ShawnVictor/Project-Quasar-Software/Quasar_Eagle_Files/Quasar_DAQ_Board/Quasar_v0.1.brd

## EAGLE design Quasar_Eagle_Files/Quasar_DAQ_Board/Quasar_v0.1.brd (2020-03-15)

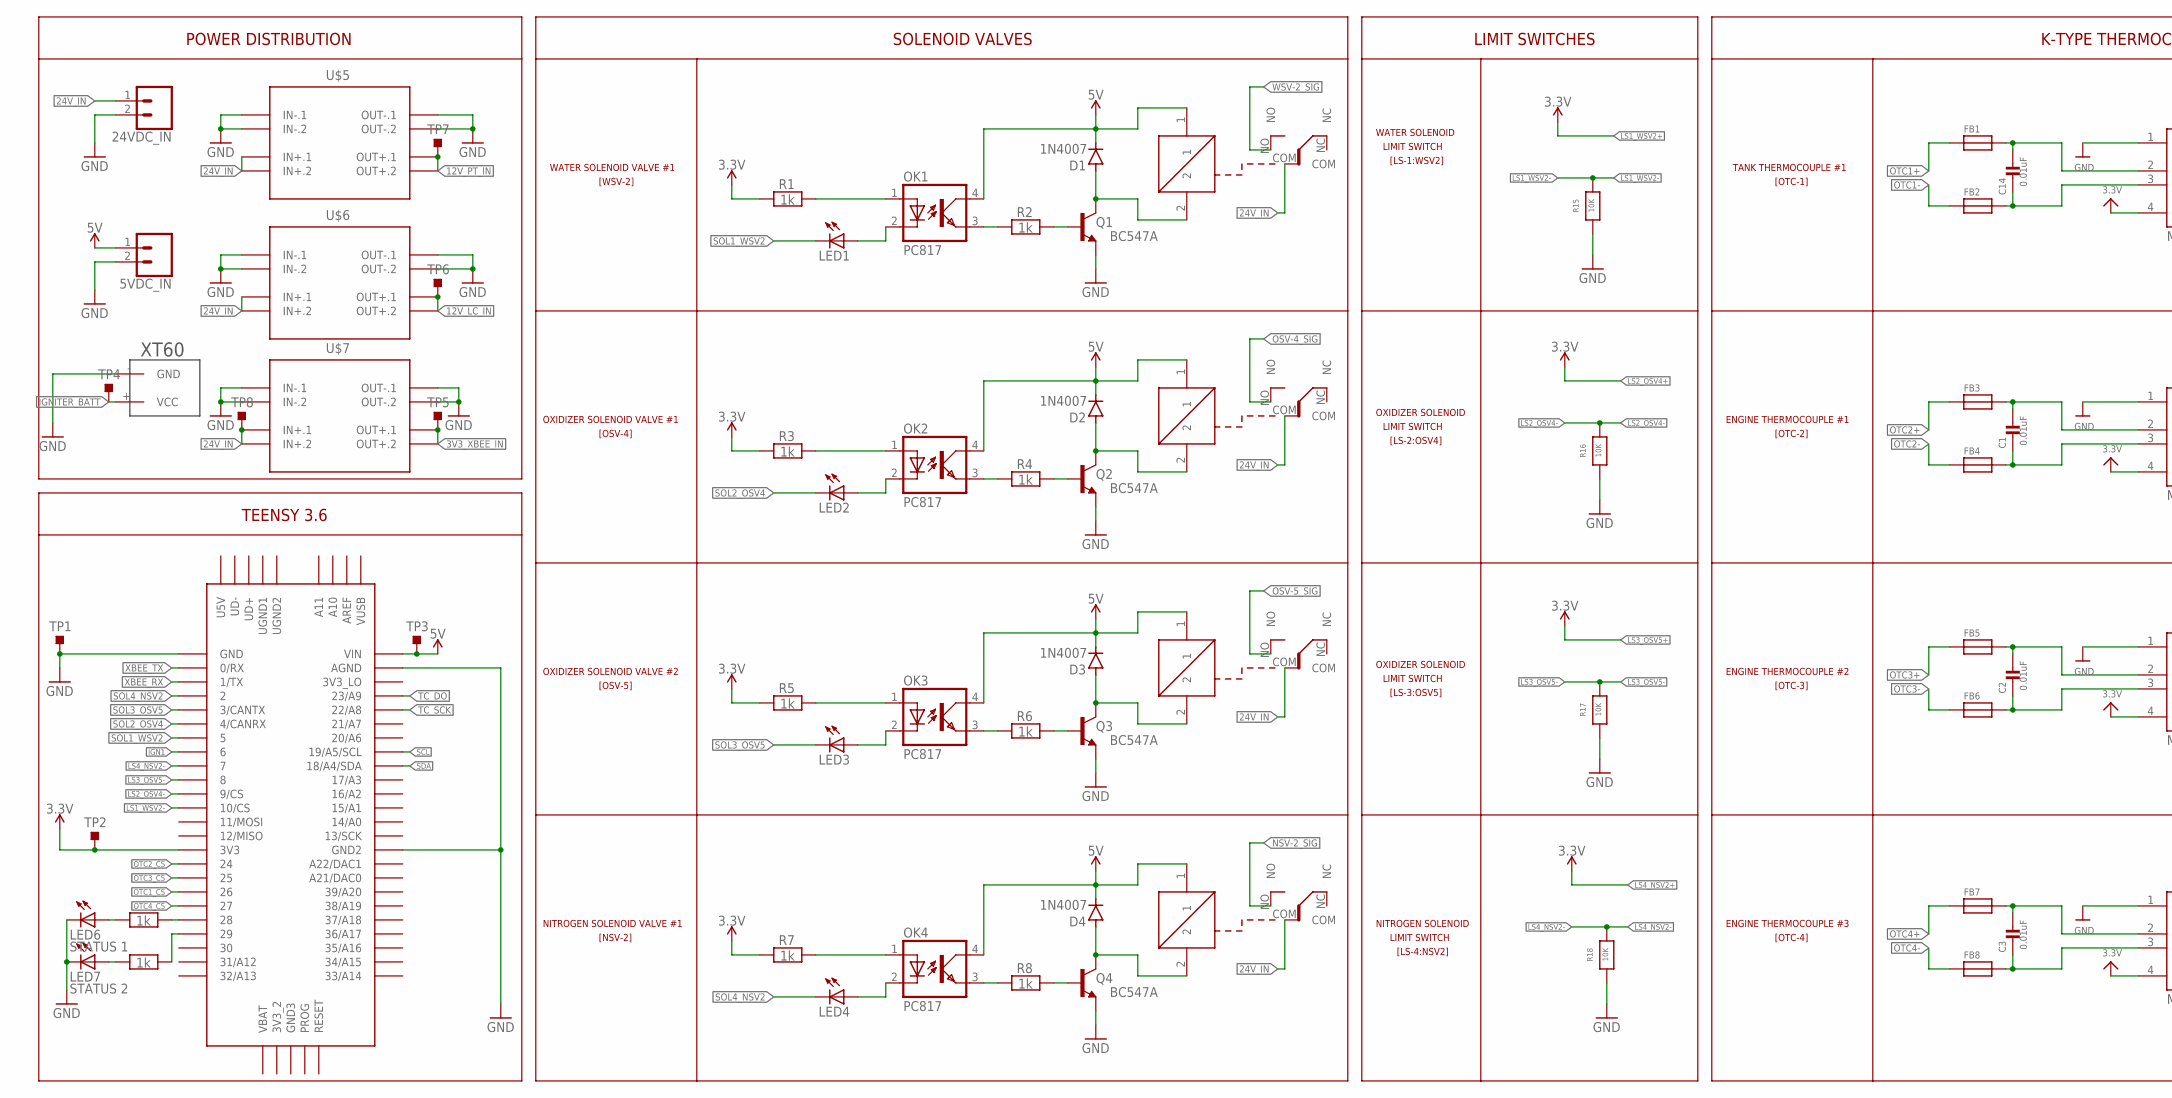
[picture p3: schematic Quasar_v0.1.sch, part in row 1, column 1]

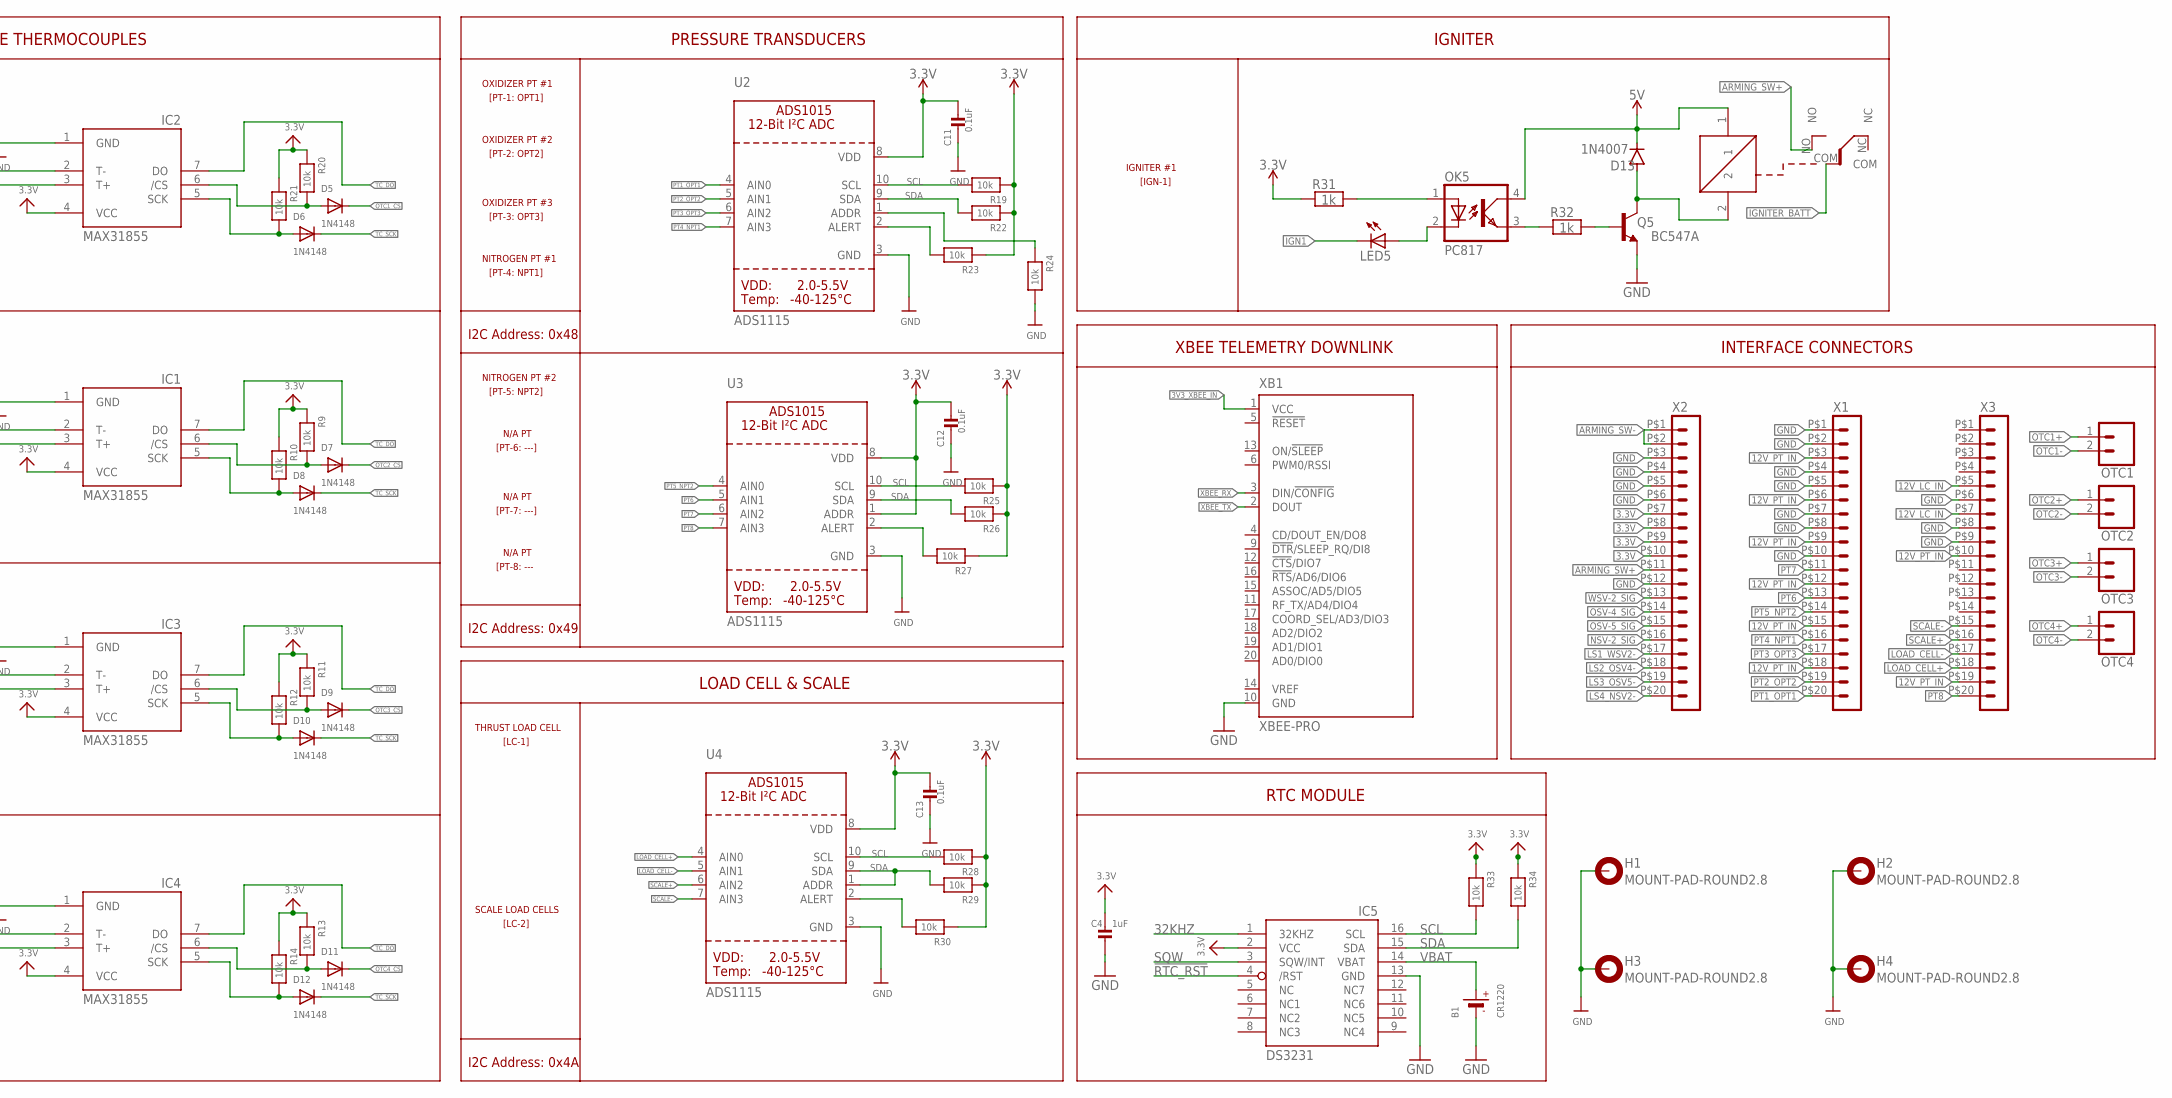
[picture p4: schematic Quasar_v0.1.sch, part in row 1, column 2]

Parts:
5VDC_IN, 24VDC_IN: CONN_025MM; SCREWTERMINAL-5MM-2
B1: CR1220
C1, C2, C3, C14: 0.01uF; 0805
C4: 1uF; 0805
C11, C12, C13: 0.1uF; 0805
D1, D2, D3, D4, D13: 1N4007; DO-41
D5, D6, D7, D8, D9, D10, D11, D12: 1N4148; SOD-123
FB1, FB2, FB3, FB4, FB5, FB6, FB7, FB8: FERRITE; 0603
H1, H2, H3, H4: MOUNT-PAD-ROUND2.8; 2,8-PAD
IC1, IC2, IC3, IC4: MAX31855; SO08
IC5: DS3231/SO; SO16W
LED1, LED2, LED3, LED4, LED5: LEDCHIPLED_1206; CHIPLED_1206
LED6: STATUS 1; LED5MM
LED7: STATUS 2; LED5MM
OK1, OK2, OK3, OK4, OK5: PC817; DIL04
OTC1, OTC2, OTC3, OTC4: CONN_025MM; SCREWTERMINAL-5MM-2
Q1, Q2, Q3, Q4, Q5: BC547A; TO92
R1, R2, R3, R4, R5, R6, R7, R8, R31, R32, R35, R36: 1k; 0805
R9, R10, R11, R12, R13, R14, R19, R20, R21, R22, R23, R24, R25, R26, R27, R28, R29, R30, R33, R34: 10k; 0805
R15, R16, R17, R18: 10K; 0805
TP1, TP2, TP3, TP4, TP5, TP6, TP7, TP8: TESTPOINT_TPS-SMD-10SN; TESTPOINT_SMD-10SN
U2, U3, U4: ADS1115; MSOP10
U$1: TEENSY_3.5/3.6
U$2, U$3, U$4, U$13, U$18: RW-SH
U$5: 12V_PT_REG; DC-DC-STEP-DOWN-MP1584
U$6: 12V_LC_REG; DC-DC-STEP-DOWN-MP1584
U$7: 3V3_XBEE_REG; DC-DC-STEP-DOWN-MP1584
U$19: XT60
X1, X2, X3: HEADER_POS20_44914-2001; 44914-2001
XB1: XBEE-PRO

Connections:
3.3V: C4.2, C11.2, C12.2, C13.2, IC1.4 (VCC), IC2.4 (VCC), IC3.4 (VCC), IC4.4 (VCC), IC5.2 (VCC), R1.2, R3.2, R5.2, R7.2, R9.1, R10.1, R11.1, R12.1, R13.1, R14.1, R19.1, R20.1, R21.1, R22.1, R23.1, R25.1, R26.1, R27.1, R28.1, R29.1, R30.1, R31.2, R33.1, R34.1, TP2.TP, U2.8 (VDD), U3.1 (ADDR), U3.8 (VDD), U4.8 (VDD), U$1.3V3, X2.P$7 (7), X2.P$8 (8), X2.P$9 (9), X2.P$10 (10)
3V3_XBEE_IN: TP5.TP, U$7.OUT+.1, U$7.OUT+.2, XB1.1 (VCC)
5V: 5VDC_IN.1, D1.C, D2.C, D3.C, D4.C, D13.C, OK1.4 (COL), OK2.4 (COL), OK3.4 (COL), OK4.4 (COL), OK5.4 (COL), TP3.TP, U$1.VIN, U$2.1, U$3.1, U$4.1, U$13.1, U$18.1
12V_LC_IN: TP6.TP, U$6.OUT+.1, U$6.OUT+.2, X3.P$5 (5), X3.P$7 (7)
12V_PT_IN: TP7.TP, U$5.OUT+.1, U$5.OUT+.2, X1.P$3 (3), X1.P$6 (6), X1.P$9 (9), X1.P$12 (12), X1.P$15 (15), X1.P$18 (18), X3.P$10 (10), X3.P$19 (19)
24V_IN: 24VDC_IN.1, TP8.TP, U$2.COM, U$3.COM, U$4.COM, U$5.IN+.1, U$5.IN+.2, U$6.IN+.1, U$6.IN+.2, U$7.IN+.1, U$7.IN+.2, U$13.COM
32KHZ: IC5.1 (32KHZ)
!RTC_RST: IC5.4 (/RST)
ARMING_SW+: U$18.NO, X2.P$11 (11)
ARMING_SW-: X2.P$1 (1), X2.P$2 (2)
GND: 5VDC_IN.2, 24VDC_IN.2, B1.-, C4.1, C11.1, C12.1, C13.1, H1.B2,8, H2.B2,8, H3.B2,8, H4.B2,8, IC1.1 (GND), IC2.1 (GND), IC3.1 (GND), IC4.1 (GND), IC5.13 (GND), LED6.K (C), LED7.K (C), Q1.1 (E), Q2.1 (E), Q3.1 (E), Q4.1 (E), Q5.1 (E), R15.2, R16.2, R17.2, R18.2, R24.2, TP1.TP, U2.3 (GND), U3.3 (GND), U4.3 (GND), U$1.AGND, U$1.GND, U$1.GND2, U$5.IN-.1, U$5.IN-.2, U$5.OUT-.1, U$5.OUT-.2, U$6.IN-.1, U$6.IN-.2, U$6.OUT-.1, U$6.OUT-.2, U$7.IN-.1, U$7.IN-.2, U$7.OUT-.1, U$7.OUT-.2, U$19.- (GND), X1.P$1 (1), X1.P$2 (2), X1.P$4 (4), X1.P$5 (5), X1.P$7 (7), X1.P$8 (8), X1.P$10 (10), X2.P$3 (3), X2.P$4 (4), X2.P$5 (5), X2.P$6 (6), X2.P$12 (12), X3.P$6 (6), X3.P$8 (8), X3.P$9 (9), XB1.10 (GND)
IGN1: LED5.C, U$1.6
IGNITER_BATT: TP4.TP, U$18.COM, U$19.+ (VCC)
LOAD_CELL+: U4.4 (AIN0), X3.P$18 (18)
LOAD_CELL-: U4.5 (AIN1), X3.P$17 (17)
LS1_WSV2-: R15.1, U$1.10/CS, X2.P$17 (17)
LS2_OSV4-: R16.1, U$1.9/CS, X2.P$18 (18)
LS3_OSV5-: R17.1, U$1.8, X2.P$19 (19)
LS4_NSV2-: R18.1, U$1.7, X2.P$20 (20)
unnamed: OK1.1 (A), R1.1
unnamed: LED1.A, OK1.2 (C)
unnamed: Q1.2 (B), R2.1
unnamed: OK1.3 (EMIT), R2.2
unnamed: D1.A, Q1.3 (C), U$13.2
unnamed: OK2.1 (A), R3.1
unnamed: LED2.A, OK2.2 (C)
unnamed: Q2.2 (B), R4.1
unnamed: OK2.3 (EMIT), R4.2
unnamed: D2.A, Q2.3 (C), U$2.2
unnamed: OK3.1 (A), R5.1
unnamed: LED3.A, OK3.2 (C)
unnamed: Q3.2 (B), R6.1
unnamed: OK3.3 (EMIT), R6.2
unnamed: D3.A, Q3.3 (C), U$3.2
unnamed: OK4.1 (A), R7.1
unnamed: LED4.A, OK4.2 (C)
unnamed: Q4.2 (B), R8.1
unnamed: OK4.3 (EMIT), R8.2
unnamed: D4.A, Q4.3 (C), U$4.2
unnamed: C1.2, FB3.2, IC1.2 (T-)
unnamed: C1.1, FB4.2, IC1.3 (T+)
unnamed: D7.A, IC1.6 (/CS), R9.2
unnamed: D8.A, IC1.5 (SCK), R10.2
unnamed: C2.2, FB5.2, IC3.2 (T-)
unnamed: C2.1, FB6.2, IC3.3 (T+)
unnamed: C14.1, FB2.2, IC2.3 (T+)
unnamed: D9.A, IC3.6 (/CS), R11.2
unnamed: D10.A, IC3.5 (SCK), R12.2
unnamed: C3.2, FB7.2, IC4.2 (T-)
unnamed: C3.1, FB8.2, IC4.3 (T+)
unnamed: C14.2, FB1.2, IC2.2 (T-)
unnamed: D11.A, IC4.6 (/CS), R13.2
unnamed: D5.A, IC2.6 (/CS), R20.2
unnamed: D12.A, IC4.5 (SCK), R14.2
unnamed: OK5.1 (A), R31.1
unnamed: LED5.A, OK5.2 (C)
unnamed: Q5.2 (B), R32.1
unnamed: R23.2, U2.2 (ALERT)
unnamed: R27.2, U3.2 (ALERT)
unnamed: R24.1, U2.1 (ADDR)
unnamed: OK5.3 (EMIT), R32.2
unnamed: D13.A, Q5.3 (C), U$18.2
unnamed: R30.2, U4.2 (ALERT)
unnamed: R35.1, U$1.28
unnamed: R36.1, U$1.29
unnamed: D6.A, IC2.5 (SCK), R21.2
unnamed: LED6.A, R35.2
unnamed: LED7.A, R36.2
NSV-2_SIG: U$4.NO, X2.P$16 (16)
OSV-4_SIG: U$2.NO, X2.P$14 (14)
OSV-5_SIG: U$3.NO, X2.P$15 (15)
OTC1+: FB1.1, OTC1.1
OTC1-: FB2.1, OTC1.2
OTC1_CS: D5.C, U$1.26
OTC2+: FB3.1, OTC2.1
OTC2-: FB4.1, OTC2.2
OTC2_CS: D7.C, U$1.24
OTC3+: FB5.1, OTC3.1
OTC3-: FB6.1, OTC3.2
OTC3_CS: D9.C, U$1.25
OTC4+: FB7.1, OTC4.1
OTC4-: FB8.1, OTC4.2
OTC4_CS: D11.C, U$1.27
PT1_OPT1: U2.4 (AIN0), X1.P$20 (20)
PT2_OPT2: U2.5 (AIN1), X1.P$19 (19)
PT3_OPT3: U2.6 (AIN2), X1.P$17 (17)
PT4_NPT1: U2.7 (AIN3), X1.P$16 (16)
PT5_NPT2: U3.4 (AIN0), X1.P$14 (14)
PT6: U3.5 (AIN1), X1.P$13 (13)
PT7: U3.6 (AIN2), X1.P$11 (11)
PT8: U3.7 (AIN3), X3.P$20 (20)
SCALE+: U4.6 (AIN2), X3.P$16 (16)
SCALE-: U4.7 (AIN3), X3.P$15 (15)
SCL: IC5.16 (SCL), R19.2, R25.2, R28.2, R33.2, U2.10 (SCL), U3.10 (SCL), U4.10 (SCL), U$1.19/A5/SCL
SDA: IC5.15 (SDA), R22.2, R26.2, R29.2, R34.2, U2.9 (SDA), U3.9 (SDA), U4.1 (ADDR), U4.9 (SDA), U$1.18/A4/SDA
SOL1_WSV2: LED1.C, U$1.5
SOL2_OSV4: LED2.C, U$1.4/CANRX
SOL3_OSV5: LED3.C, U$1.3/CANTX
SOL4_NSV2: LED4.C, U$1.2
SQW: IC5.3 (SQW/INT)
TC_DO: IC1.7 (DO), IC2.7 (DO), IC3.7 (DO), IC4.7 (DO), U$1.23/A9
TC_SCK: D6.C, D8.C, D10.C, D12.C, U$1.22/A8
VBAT: B1.+$1 (+), IC5.14 (VBAT)
WSV-2_SIG: U$13.NO, X2.P$13 (13)
XBEE_RX: U$1.1/TX, XB1.3 (DIN/!CONFIG)
XBEE_TX: U$1.0/RX, XB1.2 (DOUT)

Notes on the sheet:
POWER DISTRIBUTION
SOLENOID VALVES
WATER SOLENOID VALVE #1
[WSV-2]
OXIDIZER SOLENOID VALVE #1
[OSV-4]
OXIDIZER SOLENOID VALVE #2
[OSV-5]
NITROGEN SOLENOID VALVE #1
[NSV-2]
TEENSY 3.6
K-TYPE THERMOCOUPLES
TANK THERMOCOUPLE #1
[OTC-1]
ENGINE THERMOCOUPLE #1
[OTC-2]
ENGINE THERMOCOUPLE #2
[OTC-3]
ENGINE THERMOCOUPLE #3
[OTC-4]
LIMIT SWITCHES
WATER SOLENOID
[LS-1:WSV2]
LIMIT SWITCH
OXIDIZER SOLENOID
[LS-2:OSV4]
[LS-3:OSV5]
NITROGEN SOLENOID
[LS-4:NSV2]
PRESSURE TRANSDUCERS
OXIDIZER PT #1
[PT-1: OPT1]
I2C Address: 0x48
OXIDIZER PT #2
[PT-2: OPT2]
OXIDIZER PT #3
[PT-3: OPT3]
NITROGEN PT #1
[PT-4: NPT1]
NITROGEN PT #2
[PT-5: NPT2]
N/A PT
[PT-6: ---]
[PT-7: ---]
[PT-8: ---
I2C Address: 0x49
LOAD CELL & SCALE
THRUST LOAD CELL
[LC-1]
SCALE LOAD CELLS
[LC-2]
I2C Address: 0x4A
IGNITER
IGNITER #1
[IGN-1]
XBEE TELEMETRY DOWNLINK
RTC MODULE
INTERFACE CONNECTORS

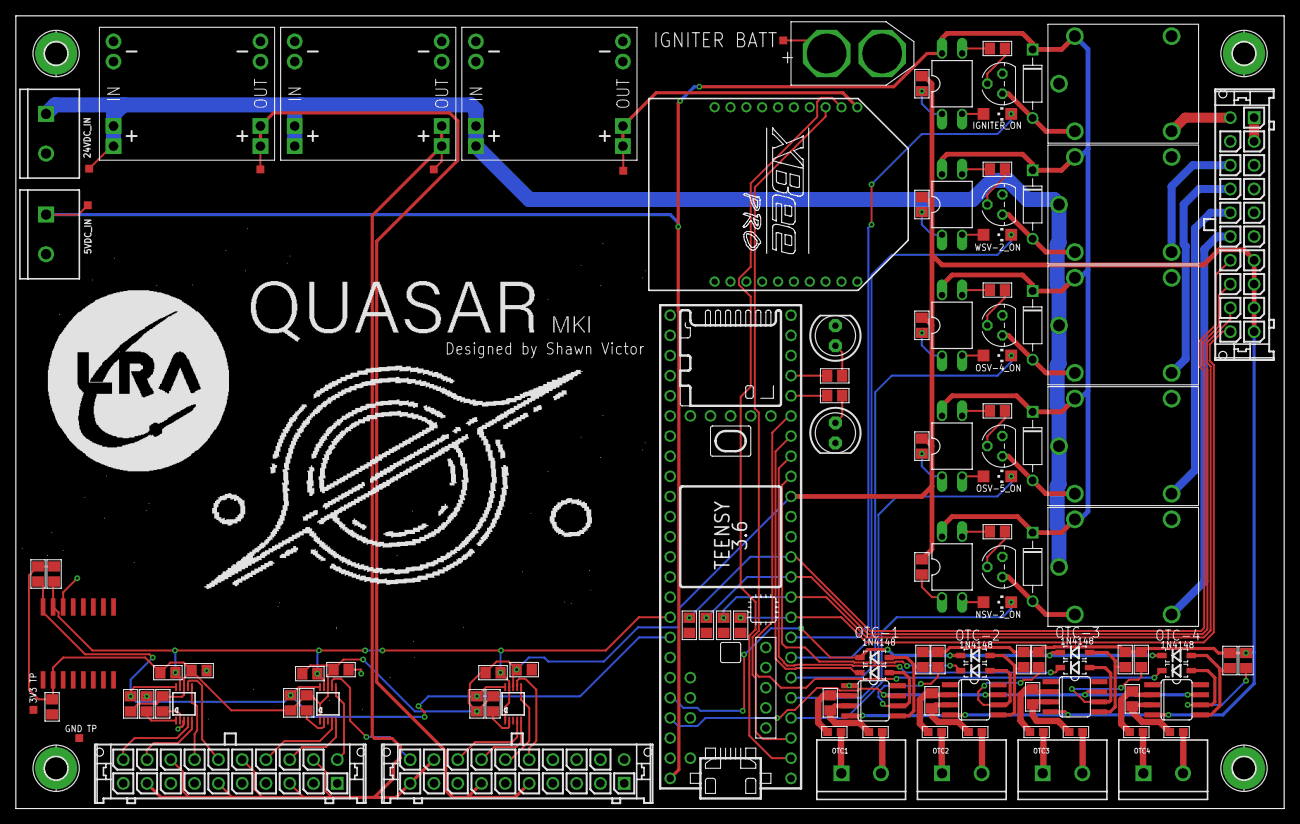
[picture p5: board Quasar_v0.1.brd from above]

Board: 2 copper layers, 160.0 x 100.0 mm, 123 parts (1 on the bottom side), 103 nets.
