ShawnVictor/Project-Quasar-Software/Quasar_Eagle_Files/Quasar_Control_Board/Quasar_Control_Board_v0.1.brd

## EAGLE design Quasar_Eagle_Files/Quasar_Control_Board/Quasar_Control_Board_v0.1.brd (2020-03-15)

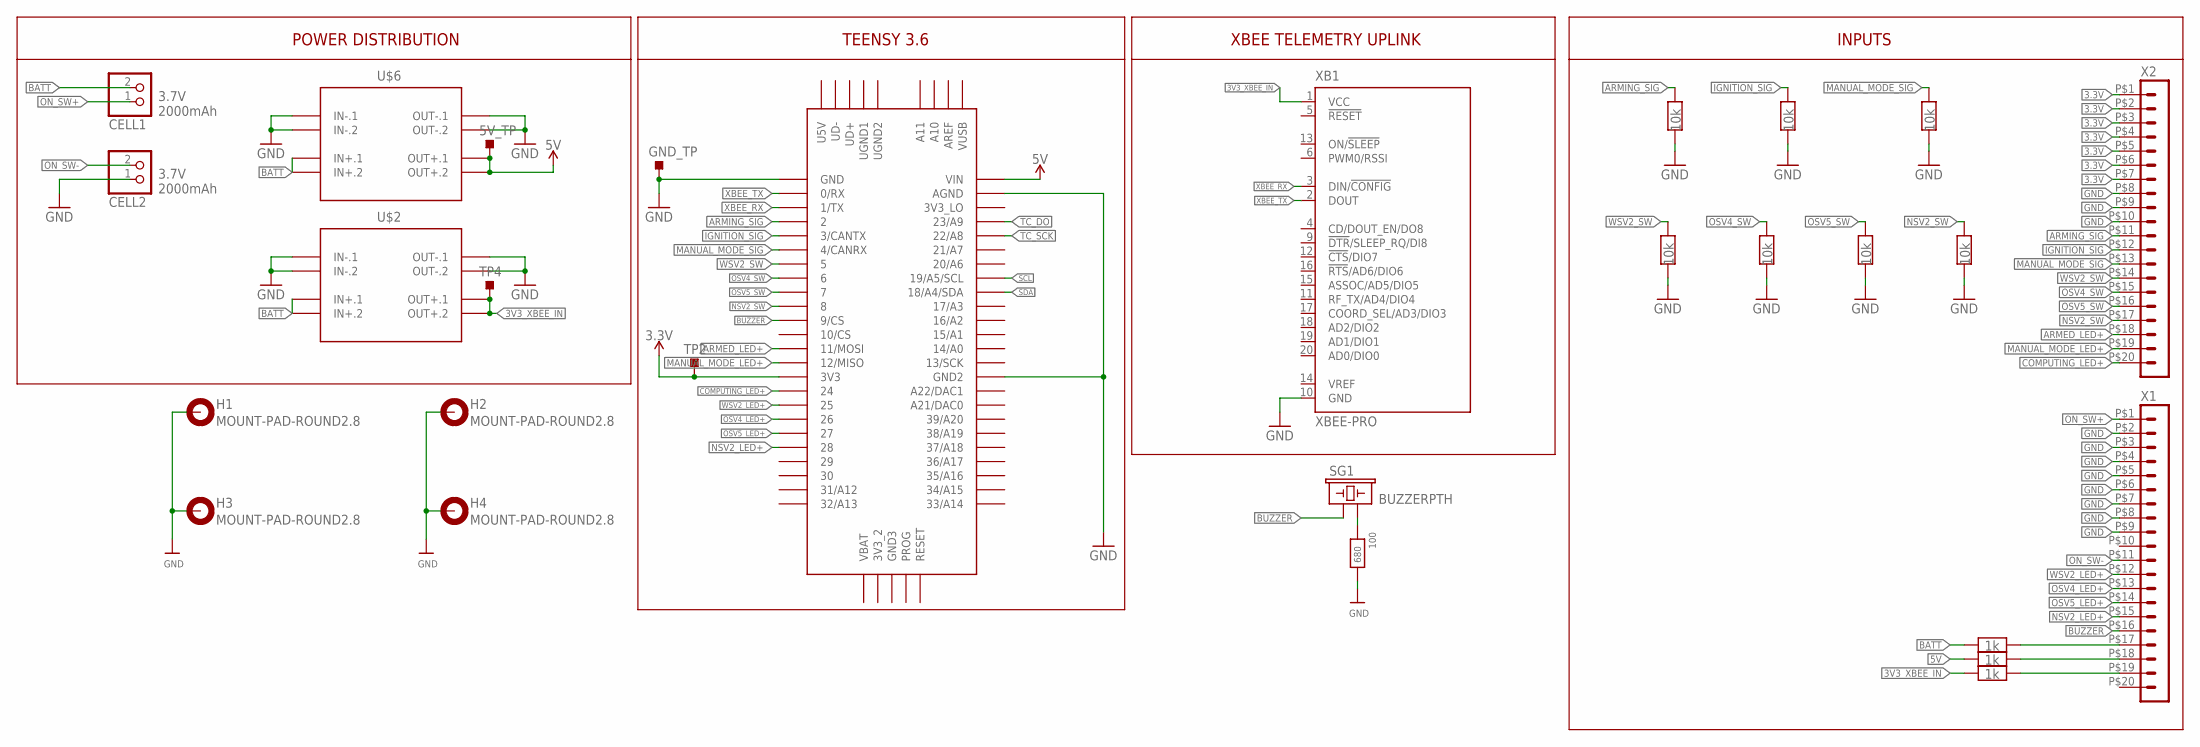
[picture p6: schematic Quasar_Control_Board_v0.1.sch]

Parts:
5V_TP: TESTPOINT_TPS-SMD-10SN; TESTPOINT_SMD-10SN
100: 680; 0603
CELL1, CELL2: JSTPH; JSTPH2
GND_TP: TESTPOINT_TPS-SMD-10SN; TESTPOINT_SMD-10SN
H1, H2, H3, H4: MOUNT-PAD-ROUND2.8; 2,8-PAD
R1, R2, R3, R4, R5, R6, R7: 10k; 0805
R8, R9, R10: 1k; 0805
SG1: BUZZERPTH; BUZZER-12MM
TP2, TP4: TESTPOINT_TPS-SMD-10SN; TESTPOINT_SMD-10SN
U$1: TEENSY_3.5/3.6
U$2, U$6: 12V_LC_REG; DC-DC-STEP-DOWN-MP1584
X1, X2: HEADER_POS20_44914-2001; 44914-2001
XB1: XBEE-PRO

Connections:
3.3V: TP2.TP, U$1.3V3, X2.P$1 (1), X2.P$2 (2), X2.P$3 (3), X2.P$4 (4), X2.P$5 (5), X2.P$6 (6), X2.P$7 (7)
3V3_XBEE_IN: R10.2, TP4.TP, U$2.OUT+.1, U$2.OUT+.2, XB1.1 (VCC)
5V: 5V_TP.TP, R9.2, U$1.VIN, U$6.OUT+.1, U$6.OUT+.2
ARMED_LED+: U$1.11/MOSI, X2.P$18 (18)
ARMING_SIG: R1.1, U$1.2, X2.P$11 (11)
BATT: CELL1.2, R8.2, U$2.IN+.1, U$2.IN+.2, U$6.IN+.1, U$6.IN+.2
BUZZER: SG1.+ (1), U$1.9/CS, X1.P$16 (16)
COMPUTING_LED+: U$1.24, X2.P$20 (20)
GND: 100.2, CELL2.1, GND_TP.TP, H1.B2,8, H2.B2,8, H3.B2,8, H4.B2,8, R1.2, R2.2, R3.2, R4.2, R5.2, R6.2, R7.2, U$1.AGND, U$1.GND, U$1.GND2, U$2.IN-.1, U$2.IN-.2, U$2.OUT-.1, U$2.OUT-.2, U$6.IN-.1, U$6.IN-.2, U$6.OUT-.1, U$6.OUT-.2, X1.P$2 (2), X1.P$3 (3), X1.P$4 (4), X1.P$5 (5), X1.P$6 (6), X1.P$7 (7), X1.P$8 (8), X1.P$9 (9), X2.P$8 (8), X2.P$9 (9), X2.P$10 (10), XB1.10 (GND)
IGNITION_SIG: R2.1, U$1.3/CANTX, X2.P$12 (12)
MANUAL_MODE_LED+: U$1.12/MISO, X2.P$19 (19)
MANUAL_MODE_SIG: R3.1, U$1.4/CANRX, X2.P$13 (13)
unnamed: R8.1, X1.P$17 (17)
unnamed: R9.1, X1.P$18 (18)
unnamed: R10.1, X1.P$19 (19)
unnamed: 100.1, SG1.- (2)
NSV2_LED+: U$1.28, X1.P$15 (15)
NSV2_SW: R7.1, U$1.8, X2.P$17 (17)
ON_SW+: CELL1.1, X1.P$1 (1)
ON_SW-: CELL2.2, X1.P$11 (11)
OSV4_LED+: U$1.26, X1.P$13 (13)
OSV4_SW: R5.1, U$1.6, X2.P$15 (15)
OSV5_LED+: U$1.27, X1.P$14 (14)
OSV5_SW: R6.1, U$1.7, X2.P$16 (16)
SCL: U$1.19/A5/SCL
SDA: U$1.18/A4/SDA
TC_DO: U$1.23/A9
TC_SCK: U$1.22/A8
WSV2_LED+: U$1.25, X1.P$12 (12)
WSV2_SW: R4.1, U$1.5, X2.P$14 (14)
XBEE_RX: U$1.1/TX, XB1.3 (DIN/!CONFIG)
XBEE_TX: U$1.0/RX, XB1.2 (DOUT)

Notes on the sheet:
TEENSY 3.6
XBEE TELEMETRY UPLINK
POWER DISTRIBUTION
3.7V 2000mAh
INPUTS

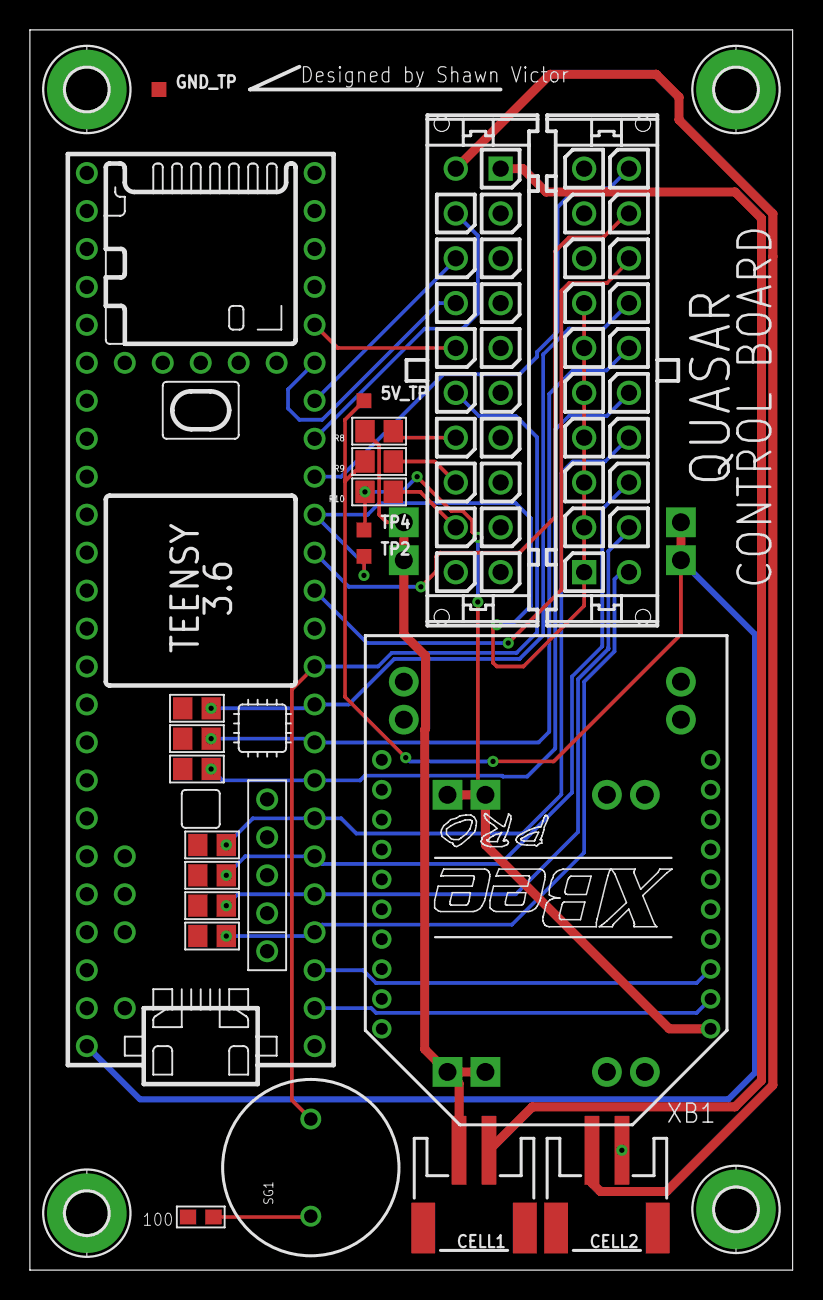
[picture p7: board Quasar_Control_Board_v0.1.brd from above]

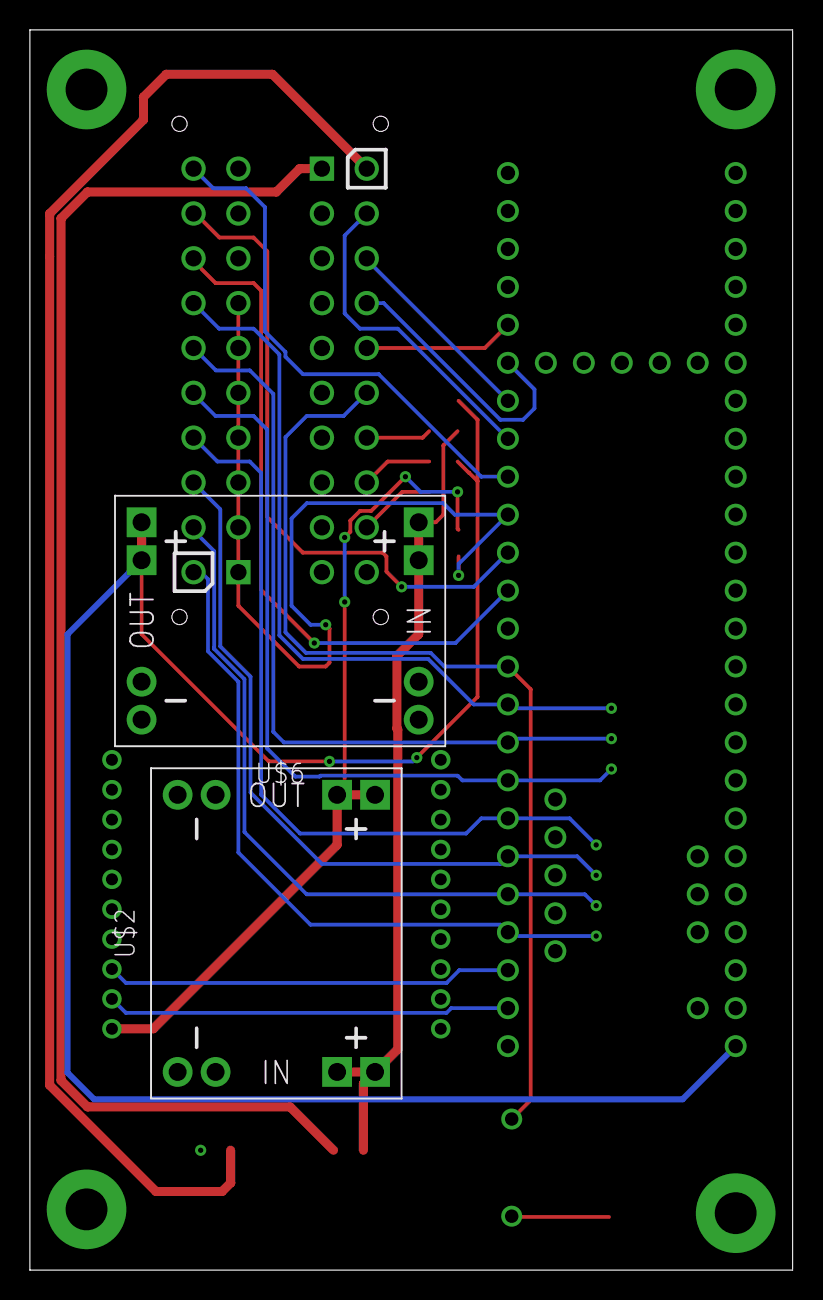
[picture p8: board Quasar_Control_Board_v0.1.brd from below]

Board: 2 copper layers, 51.0 x 83.0 mm, 28 parts (2 on the bottom side), 28 nets.
