ShawnVictor/Project-Quasar-Software/(commit log)

2020-02-04 Added in Globals and Pin Comments.
2020-02-05 Added in macros for each pin
2020-02-08 added all getter functions and serial printing functionality. Some issues, need to test further
    [DAQ-Code.ino]
2020-02-09 Fixed igniter RX code.
    [DAQ-Code.ino]
2020-02-26 Fixed Thread Break Issue & TC work now.
    [DAQ-Code.ino]
2020-03-15 Copy & Pasted from prototype files.
2020-03-15 Cleaned up code & Added Pin Declarations at top.
2020-03-15 Added in Eagle Files.
    [Quasar_Control_Board_v0.1.brd, Quasar_Control_Board_v0.1.sch, Quasar_v0.1.brd, Quasar_v0.1.sch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]
2020-03-15 Fixed Timing Issue. Code is a bit more stable.
    [DAQ-Code.ino]
2020-03-15 Fixed the Heartbeat. Output a bit more stable.
    [DAQ-Code.ino]
